starshipmonkey/Eighty8/README.md

# Project Eighty8

Read the latest blog post here: https://github.com/starshipmonkey/Eighty8/blob/main/88-Update-Blog/2025-03-12.md

## Overview
Project Eighty8 is an experimental robot designed for novel interaction, entertainment, and companionship. The robot autonomously detects and tracks human faces and bodies, physically moving to maintain "attention" on people in its environment.

## Purpose
This project explores human-machine interaction by creating a device that:
- Automatically detects human presence
- Prioritizes faces over bodies for tracking
- Physically moves and orients itself toward subjects of interest
- Creates a sense of companionship through responsive movement

## System Architecture
Project Eighty8 utilizes a two-device system:

### 1. Vision Processing System (Grove Vision AI V2 camera)
- **Hardware**: Grove Vision AI V2 camera
- **Function**: 
  - Runs machine learning models to detect faces and people (detectnet)
  - Processes video feed in real-time
  - Calculates target position, size, and confidence values

### 2. Main Processor (Adafruit HUZZAH32 - ESP32 Feather)
- **Hardware**: Adafruit HUZZAH32 - ESP32 Feather + DC motors + Servo motors
- **Function**:
  - Receives target data from grove via I2C
  - Prioritizes and selects targets based on type and proximity
  - Controls differential steering for horizontal tracking
  - Manages servo motors for vertical neck movement
  - Performs probabalistic mapping
  - Reads and fuses sensor information

## Physical Design

The robot features:

- **Mobility System**: Differential steering using two DC motors that allow the robot to rotate in place and move in any direction by varying the relative speed of the motors
- **Articulated Camera**: A 2-joint neck controlled by servo motors, allowing vertical (up/down) aiming of the camera
- **Design Constraint**: The robot must turn its entire body to track targets horizontally, as the neck only provides vertical movement

### Movement & Tracking Mechanics
- **Horizontal Tracking**: When a target moves left or right, the entire robot body rotates using differential steering
- **Vertical Tracking**: The 2-joint neck adjusts to look up or down at targets of different heights
- **Target Prioritization**: Faces are given higher priority than bodies, and larger faces (closer to the robot) receive highest attention

Screenshot from 2025-03-04 09-16-57
Screenshot from 2025-03-04 09-17-18
Screenshot from 2025-03-04 09-18-04
Screenshot from 2025-03-04 09-17-35
Screenshot from 2025-03-04 09-19-54
Screenshot from 2025-03-04 09-20-31

## How It Works

### Vision Detection
1. The Grove Vision AI module continuously processes camera images using embedded machine learning
2. When faces or people are detected, their positions and dimensions are calculated and sent to the ESP32 over IC2

### Target Selection
1. The ESP32 receives detection data from the Grove Vision AI V2
2. Targets are categorized as either FACE or PERSON
3. The system prioritizes:
   - Faces over people
   - Larger faces (presumed to be closer)
   - Higher-confidence detections

### Motor Control
1. Target coordinates are converted to motor positions
2. DC motors adjust robot body orientation for horizontal tracking
3. Servo motors adjust the neck position for vertical tracking
4. The system continuously updates motor positions as targets move

## Technical Implementation

- **The ESP32 is programmed in VS Code using Platform IO with OTA updates, and telnet serial monitoring.
- **Real-time Vision Processing**: Uses Seeed's SSCMA library for efficient on-device machine learning
- **Differential Steering**: Controls robot rotation by varying relative motor speeds
- **Servo Control**: Provides precise positioning of the 2-joint neck for vertical tracking
- **Target Management**: Implements sophisticated algorithms to select and track the most relevant target
- Sensor fusion is used for navigation and obstical avoidence

## Project Components
- Grove Vision AI V2 (Camera with embedded ML processing)
- Adafruit HUZZAH32 - ESP32 Feather (Main processor) with custom breadboard breakout
  - https://learn.adafruit.com/adafruit-huzzah32-esp32-feather/pinouts
- TCA9548A IIC Multiplex
  - https://learn.adafruit.com/adafruit-tca9548a-1-to-8-i2c-multiplexer-breakout/overview
- MPU-6050 3 Axis Gyroscope + Accelerometer
  - https://www.instructables.com/MPU-6050-Tutorial-How-to-Program-MPU-6050-With-Ard/
- HMC5883L Triple Axis Compass Magnetometer
  - http://wiki.sunfounder.cc/index.php?title=HMC5883L
- VL53L0X - Time-of-Flight (ToF) ranging sensor
  - https://docs.sunfounder.com/projects/umsk/en/latest/02_arduino/uno_lesson21_vl53l0x.html
- Dual H-Bridge Motor Driver L298N
- DC Motors (Differential steering)
- PCA9685 Servomotor Driver
  - https://circuitdigest.com/microcontroller-projects/pca9685-multiple-servo-control-using-arduino
- Servo Motors (2-joint vertical neck control)
- 2S Lithium battery, DC-DC Converter, and custom breadboard 5v/3.3v/G rail.
