starshipmonkey/Eighty8/(commit log)

2025-03-03 Update README.md
    Added onshape CAD renders
2025-03-09 Enhance motor control logic and add target tracking functionality
    - Adjusted motor speed settings to ensure minimum speed threshold.
    - Introduced target tracking function to improve target detection accuracy.
    - Added debug output for centerX calculation to assist in troubleshooting.
    - Updated Receiver.cpp to include detailed logging for target data processing.
2025-03-21 Add ESP32 project files and WiFi configuration template
    - Update .gitignore for PlatformIO project
    - Add WiFi configuration example
    - Add secure configuration setup instructions
